ryood/AnVCO/PXL_20220321_074454438.jpg

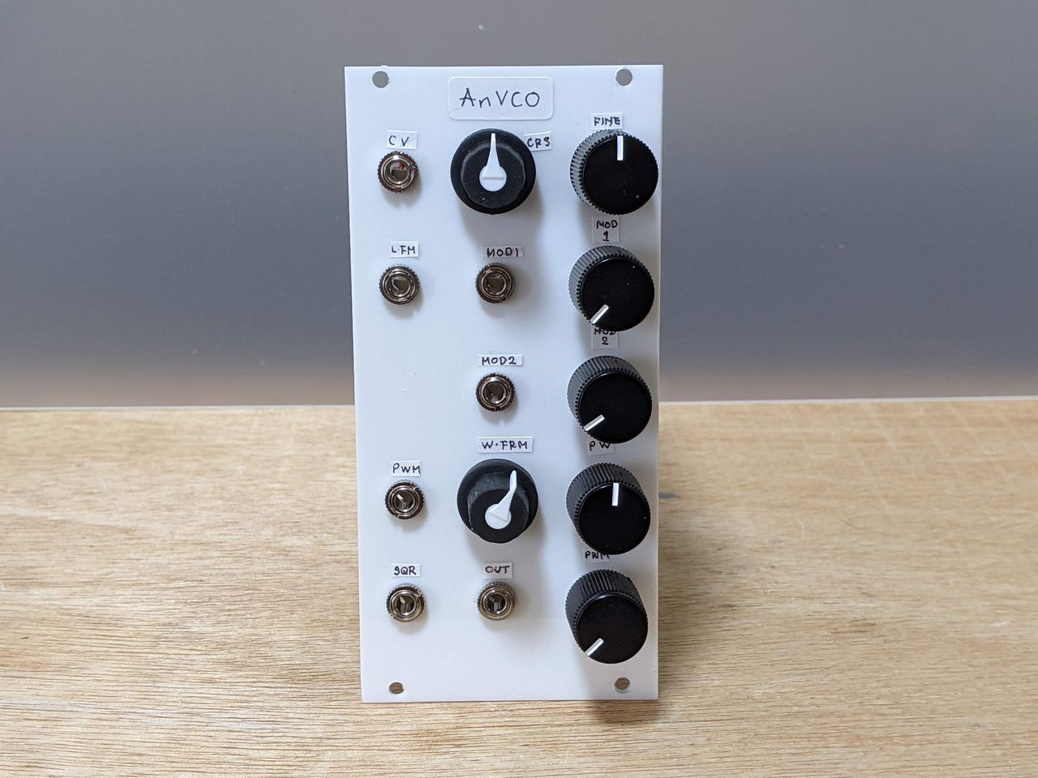
PXL_20220321_074454438.jpg
