ryood/AnVCO/PXL_20220321_074515336.jpg

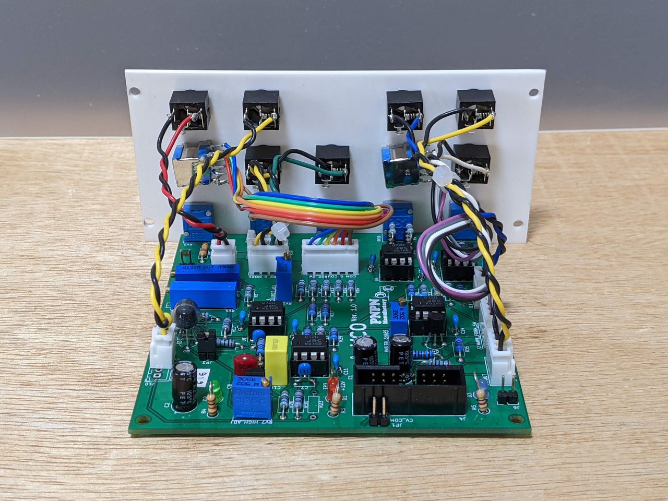
PXL_20220321_074515336.jpg
