ryood/AnVCO/README.md

AnVCO

Analog VCO
  Sawtooth
  Triangle
  Square
