ryood/AnVCO/AnVCO_CVvsOUT_Graph.png

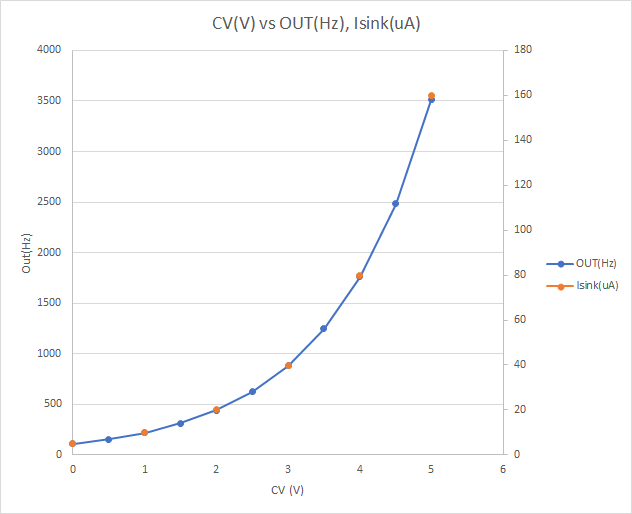
AnVCO_CVvsOUT_Graph.png
