ryood/AnVCO/KiCAD/Anti-Log_sch.PNG

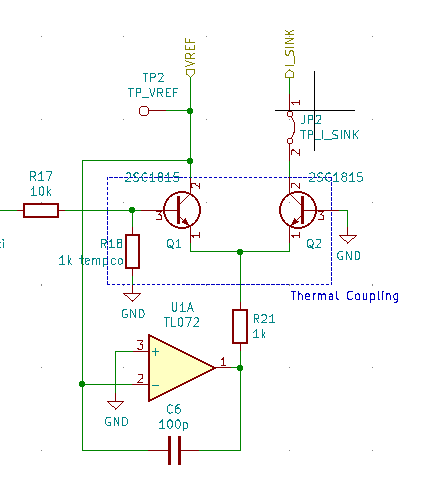
KiCAD/Anti-Log_sch.PNG
