ryood/AnVCO/KiCAD/AnVCO.png

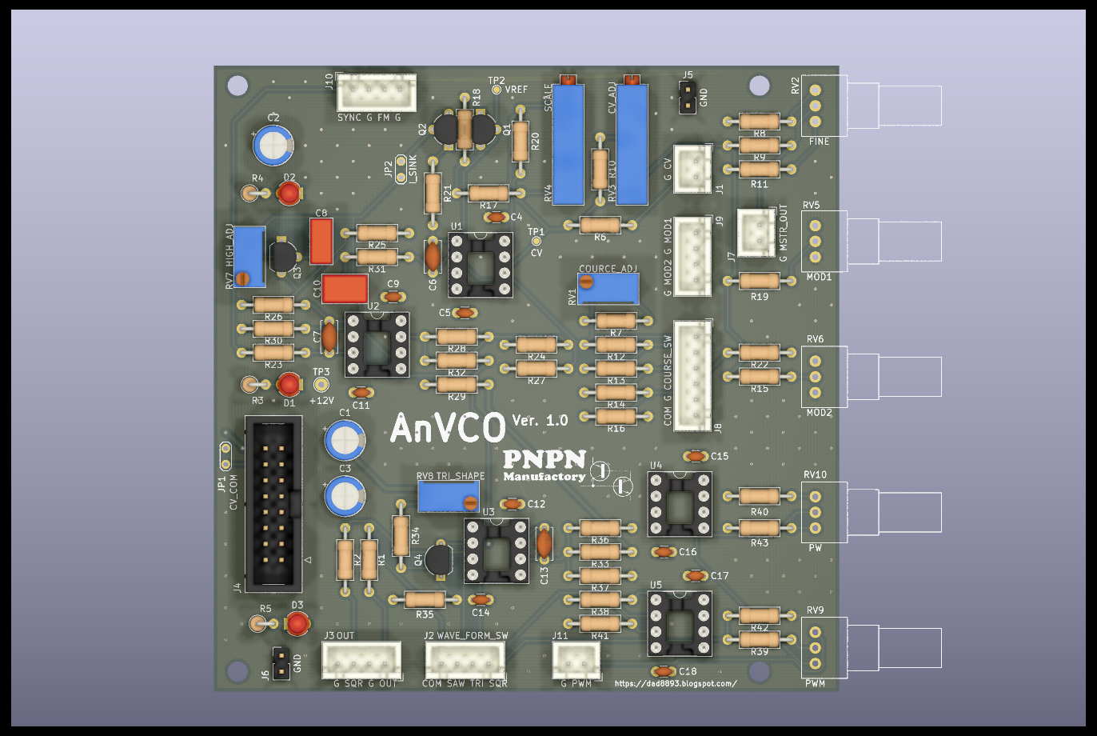
KiCAD/AnVCO.png
