ryood/AnVCO/KiCAD/AnVCO_sch_P1.png

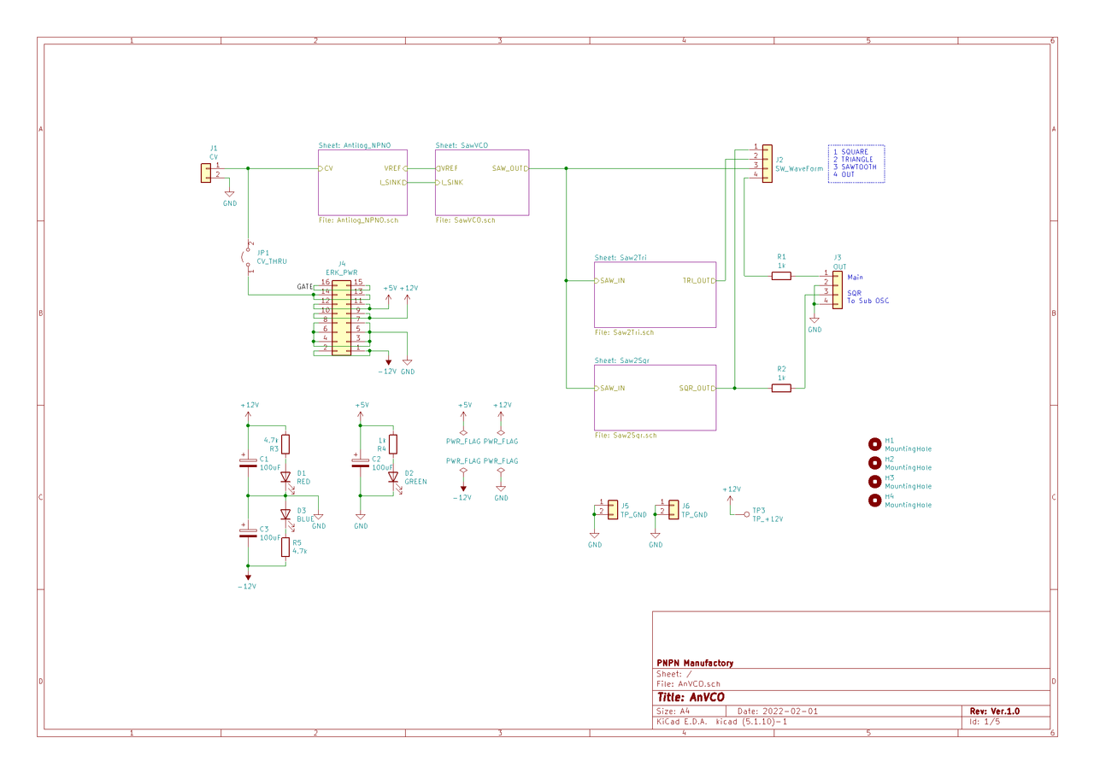
KiCAD/AnVCO_sch_P1.png
