ryood/AnVCO/KiCAD/AnVCO_sch_P2.png

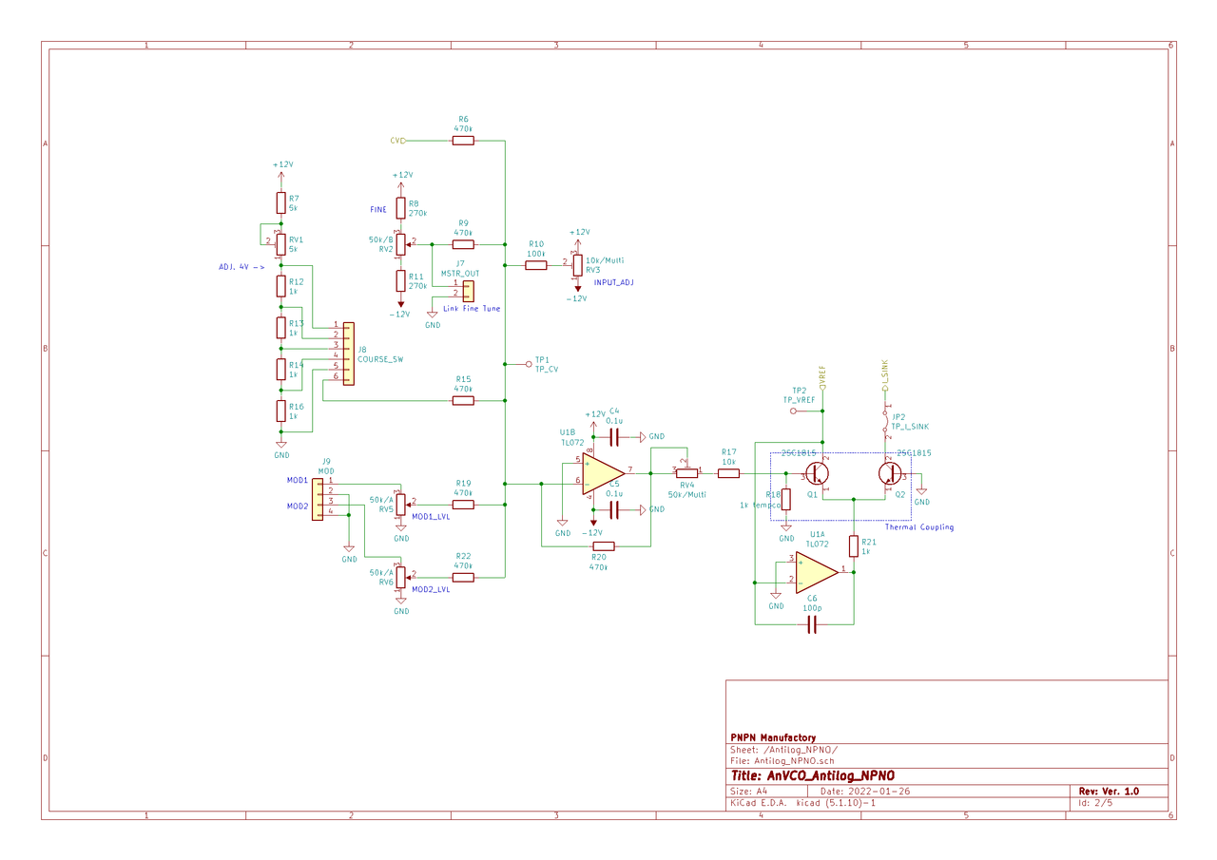
KiCAD/AnVCO_sch_P2.png
