ryood/AnVCO/KiCAD/AnVCO_sch_P3.png

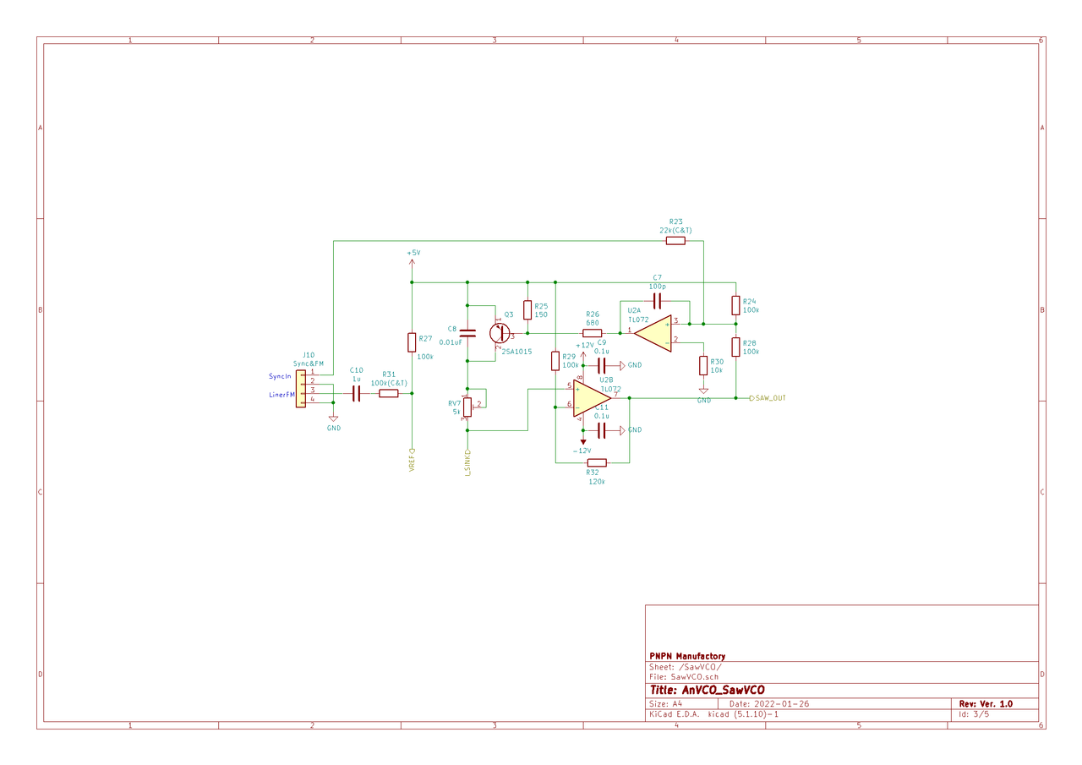
KiCAD/AnVCO_sch_P3.png
