ryood/AnVCO/KiCAD/AnVCO_sch_P4.png

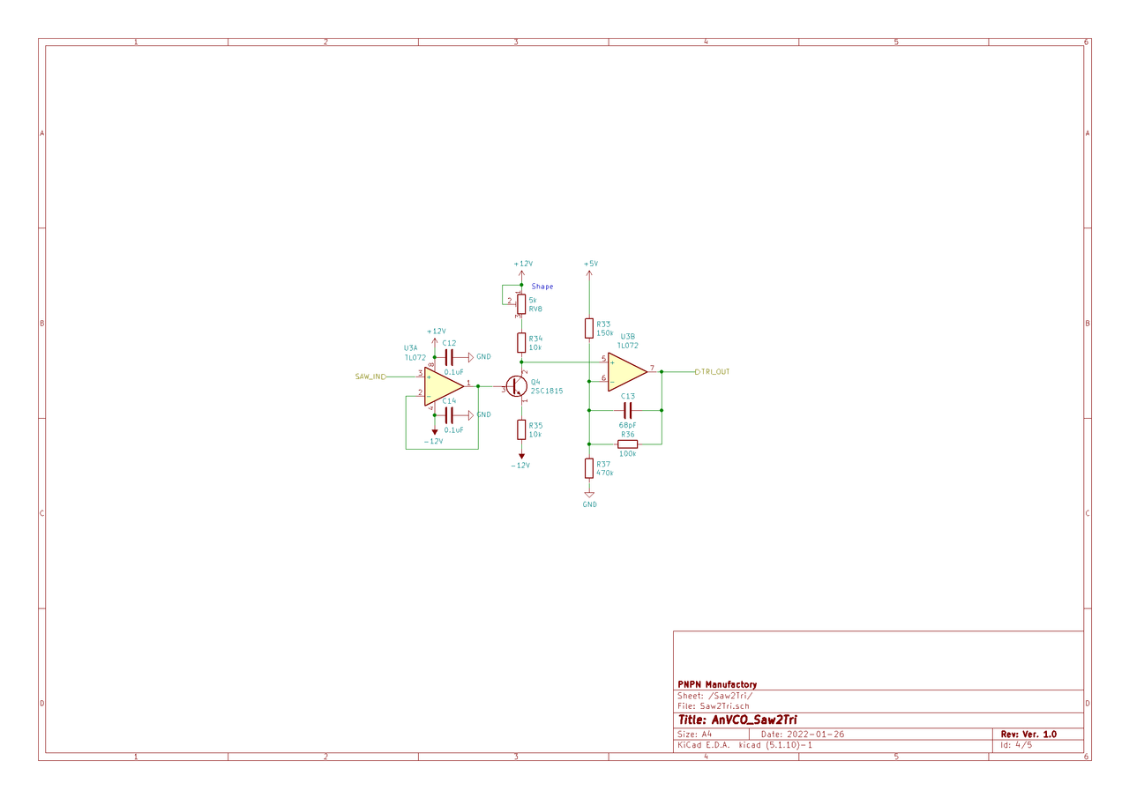
KiCAD/AnVCO_sch_P4.png
