ryood/AnVCO/KiCAD/AnVCO_sch_P5.png

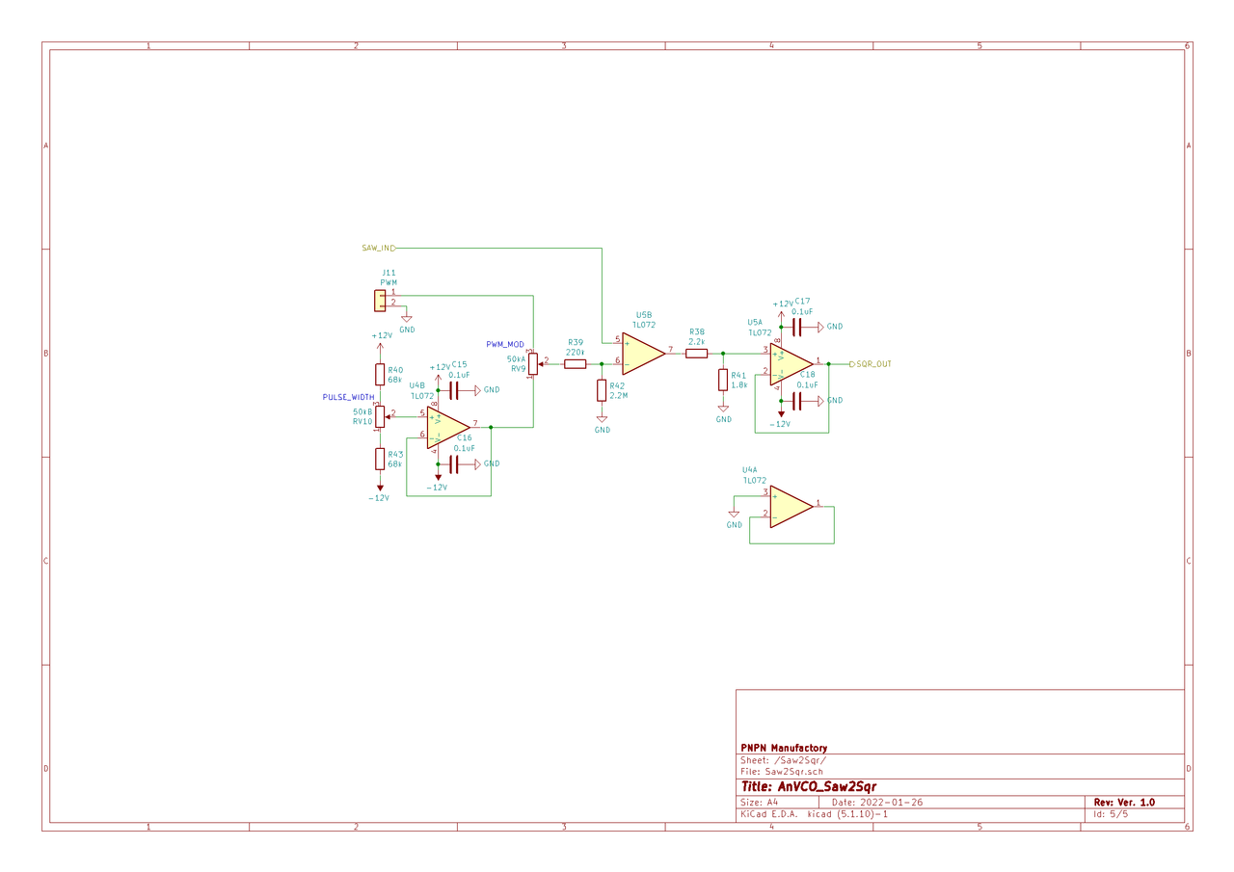
KiCAD/AnVCO_sch_P5.png
