ryood/AnVCO/KiCAD/IMG_20220314_0001.jpg

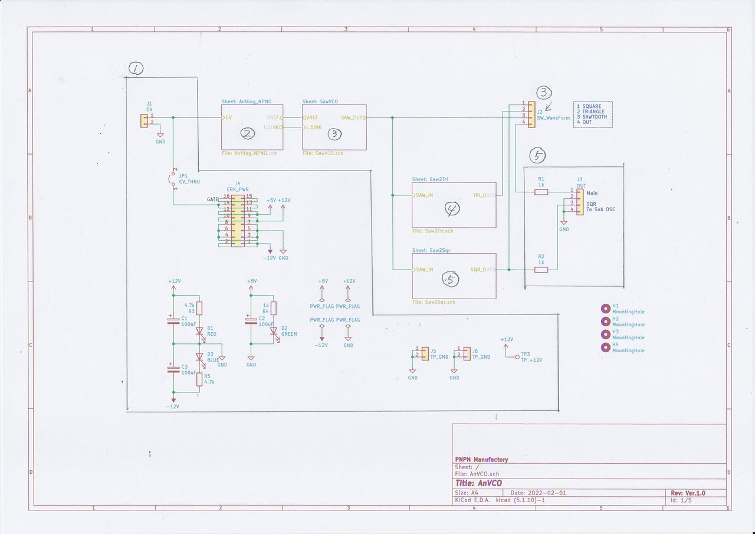
KiCAD/IMG_20220314_0001.jpg
