ryood/AnVCO/KiCAD/IMG_20220318_0003.jpg

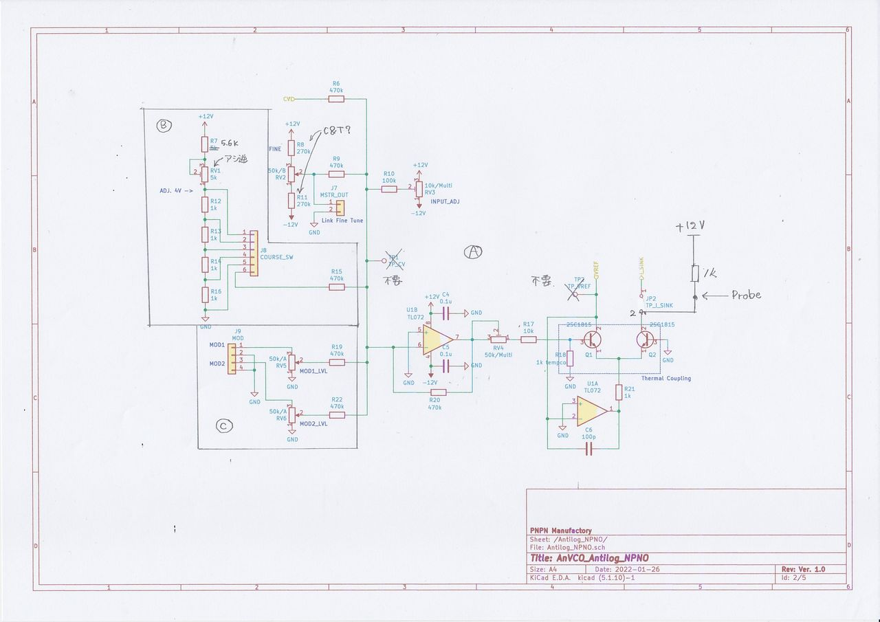
KiCAD/IMG_20220318_0003.jpg
