ryood/AnVCO/KiCAD/IMG_20220320_0001.jpg

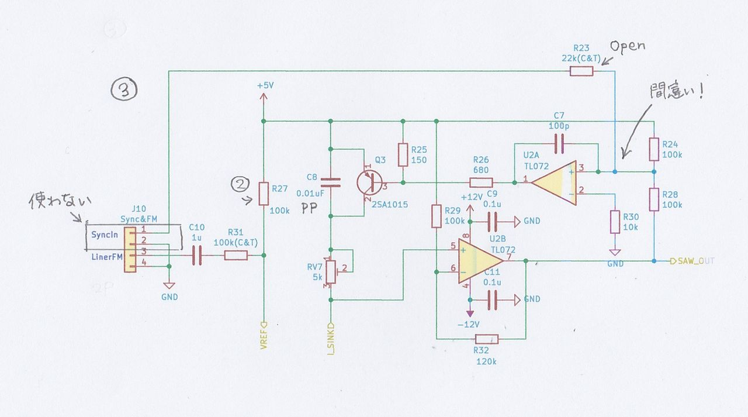
KiCAD/IMG_20220320_0001.jpg
