ryood/AnVCO/KiCAD/IMG_20220321_0001.jpg

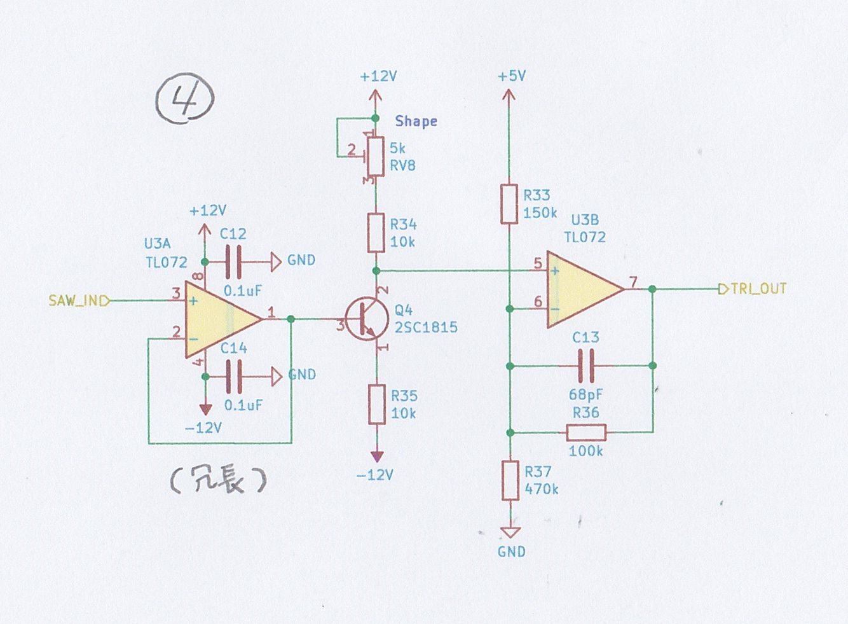
KiCAD/IMG_20220321_0001.jpg
