ryood/AnVCO/KiCAD/IMG_20220321_0003.jpg

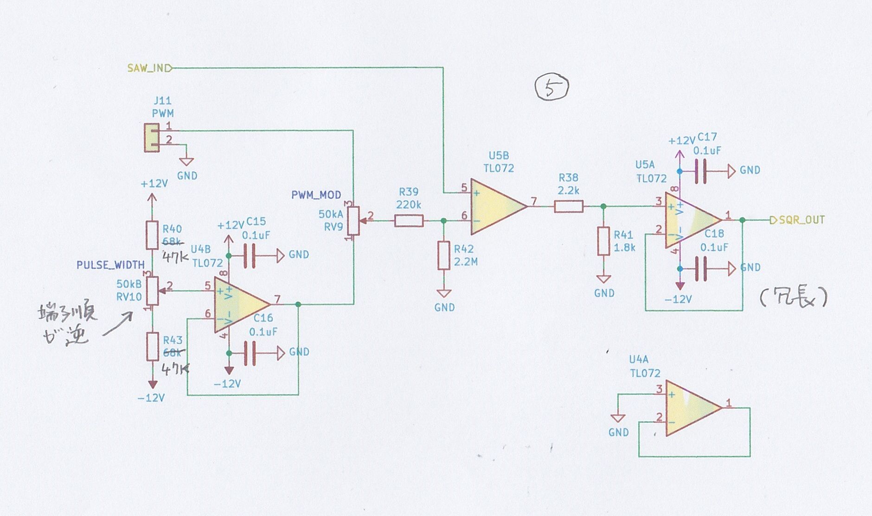
KiCAD/IMG_20220321_0003.jpg
