ryood/AnVCO/PXL_20220221_082823391.jpg

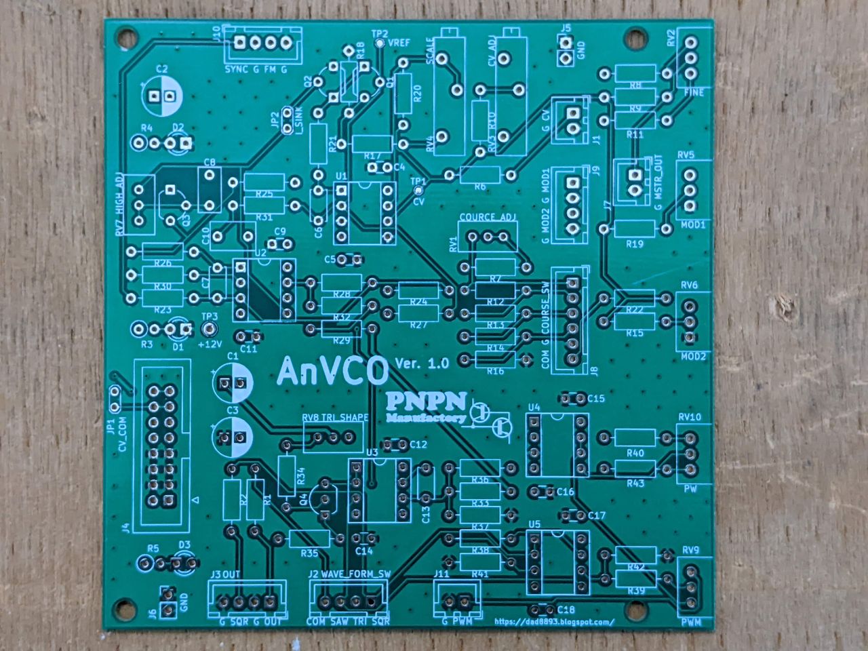
PXL_20220221_082823391.jpg
