ryood/AnVCO/PXL_20220308_063549743.MP.jpg

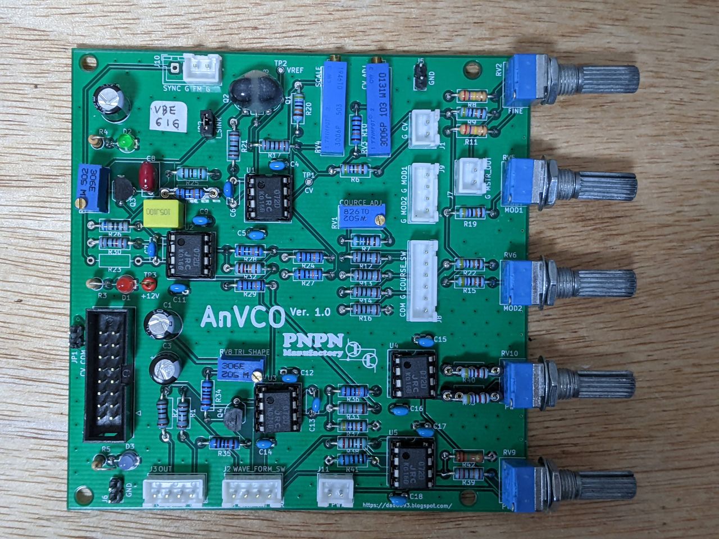
PXL_20220308_063549743.MP.jpg
