ryood/AnVCO/PXL_20220321_074503759.jpg

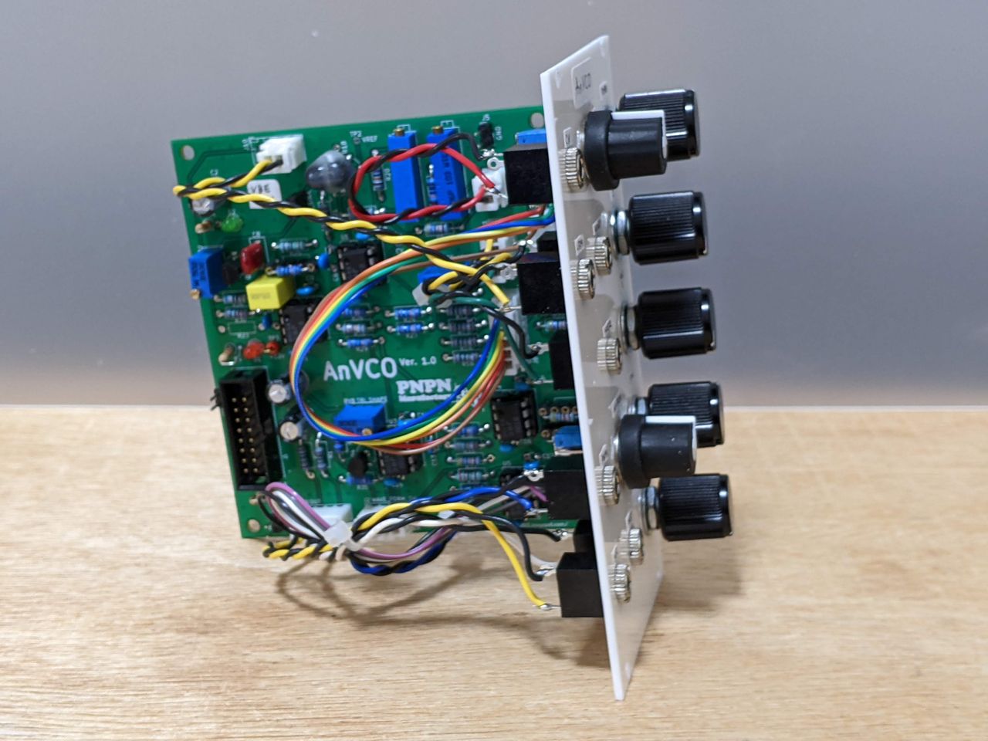
PXL_20220321_074503759.jpg
