ryood/AnVCO/(list of files, cad)

Other CAD files:
CAD/AnVCO_Panel.dwg
CAD/AnVCO_Panel_HP10_R1.dwg
CAD/AnVCO_Panel_HP12.dwg
