ryood/AnVCO/Anti-Log_Test.png

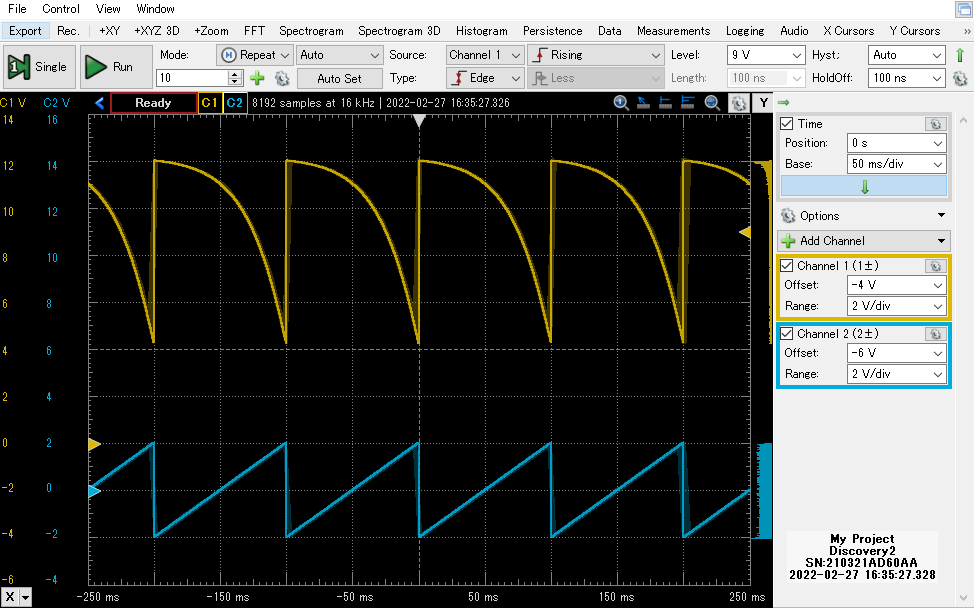
Anti-Log_Test.png
