ryood/AnVCO/spice/Antilog_NPNO_Courase_Test.asc

R1: res; 8k
R2: res; 1k
R3: res; 1k
R4: res; 1k
R5: res; 1k
R6: res; 270k
R7: res; {50k-Rfine}
R8: res; {Rfine}
R9: res; 270k
R10: res; 470k
R11: res; 470k
R12: res; 470k
R13: res; 470k
U1: UniversalOpamp2
V1: voltage; 12
V2: voltage; -12
V3: voltage; SINE(1 1 1k)
Named nets: 0, +12V, C0, C1, C2, C3, C4, -12V, FINE, OUT, CV
.step param Rfine 10k 40k 5k
.tran 3m
