ryood/AnVCO/spice/Antilog_NPNO_Courase_Test_2.asc

R1: res; {12k-Rcoarse}
R5: res; {Rcoarse}
R6: res; 270k
R7: res; {50k-Rfine}
R8: res; {Rfine}
R9: res; 270k
R10: res; 470k
R11: res; 470k
R12: res; 470k
R13: res; 470k
U1: UniversalOpamp2
V1: voltage; 12
V2: voltage; -12
V3: voltage; SINE(1 1 1k)
Named nets: 0, +12V, COARSE, -12V, FINE, OUT, CV
.param Rfine 20k
.tran 3m
.step param Rcoarse list 1 1k 2k   3k 4k
