ryood/AnVCO/spice/Couarce_SW_470k.asc

R1: res; {12k-R}
R2: res; {R}
R3: res; 470k
V1: voltage; 12V
Named nets: 0, OUT
.param R=4k
.tran 1m
