ryood/AnVCO/spice/Couarce_SW_470k_LowImp.asc

R1: res; {1.2k-R}
R2: res; {R}
R3: res; 470k
V1: voltage; 12V
Named nets: 0, OUT
.param R=400
.tran 1m
