ryood/AnVCO/(list of files, drawings)

Other design files:
KiCAD/AnVCO/AnVCO.dsn
