ryood/AnVCO/KiCAD/AnVCO/AnVCO.kicad_pcb

## KiCad design KiCAD/AnVCO/AnVCO.kicad_pcb (2022-03-22)

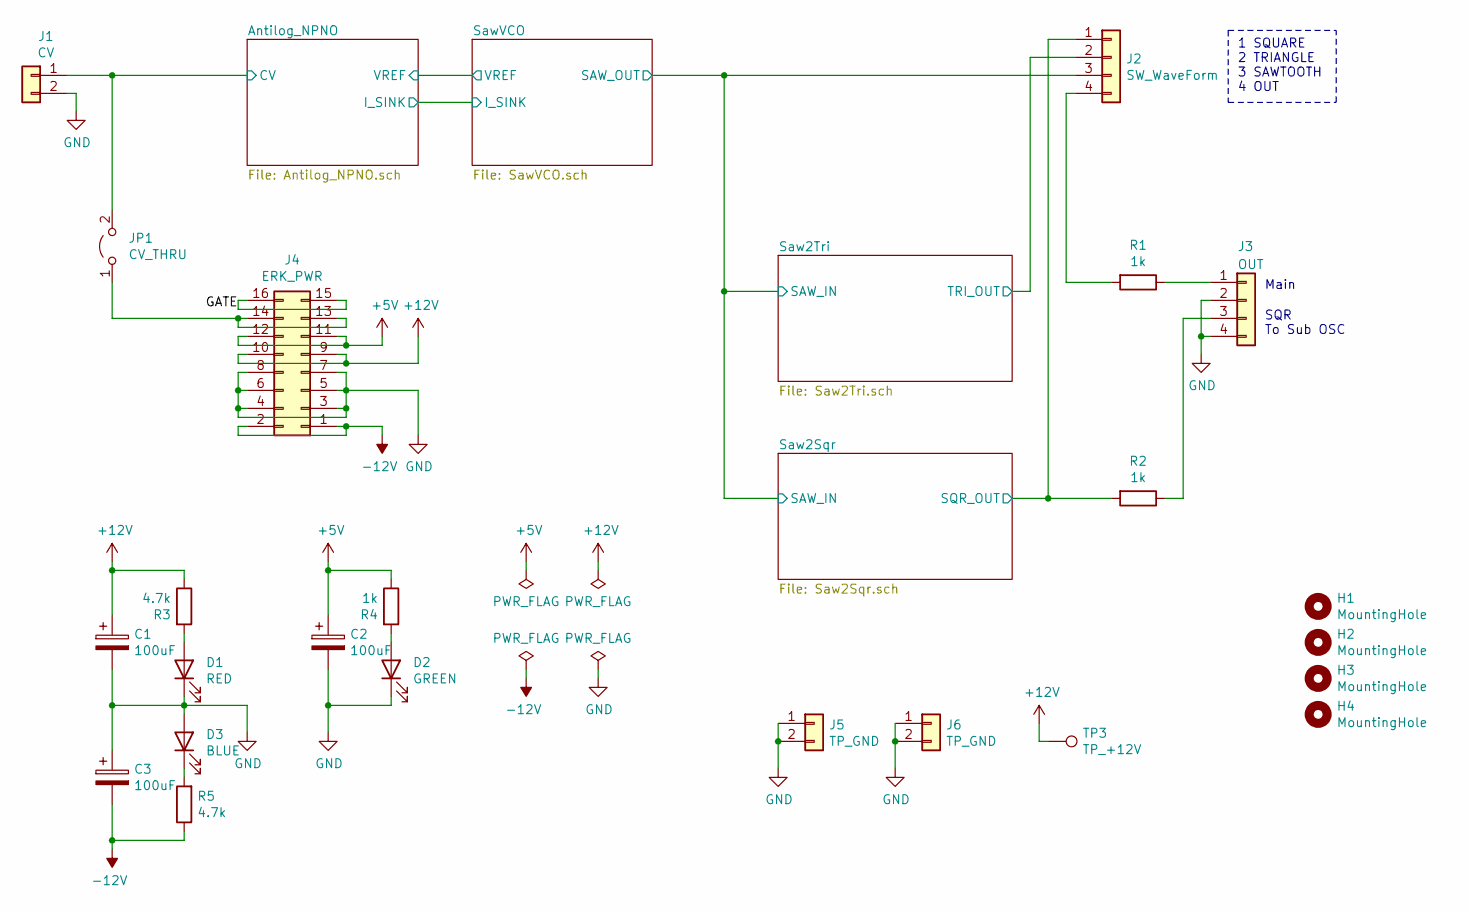
[picture p20: schematic AnVCO.sch]

Parts:
C1, C2, C3: 100uF; CP_Radial_D6.3mm_P2.50mm
D1: RED; LED_D3.0mm
D2: GREEN; LED_D3.0mm
D3: BLUE; LED_D3.0mm
H1, H2, H3, H4: MountingHole; MountingHole_3.2mm_M3
J1: CV; JST_XH_B2B-XH-A_1x02_P2.50mm_Vertical
J2: SW_WaveForm; JST_XH_B4B-XH-A_1x04_P2.50mm_Vertical
J3: OUT; JST_XH_B4B-XH-A_1x04_P2.50mm_Vertical
J4: ERK_PWR; IDC-Header_2x08_P2.54mm_Vertical
J5, J6: TP_GND; PinHeader_1x02_P2.54mm_Vertical
JP1: CV_THRU; TestPoint_2Pads_Pitch2.54mm_Drill0.8mm
R1, R2: 1k; R_Axial_DIN0207_L6.3mm_D2.5mm_P10.16mm_Horizontal
R3, R5: 4.7k; R_Axial_DIN0207_L6.3mm_D2.5mm_P2.54mm_Vertical
R4: 1k; R_Axial_DIN0207_L6.3mm_D2.5mm_P2.54mm_Vertical
TP3: TP_+12V; TestPoint_THTPad_D2.0mm_Drill1.0mm

Connections:
+5V: C2.1, J4.11, J4.12, R4.1; also elsewhere on the board
+12V: C1.1, J4.9, J4.10, R3.1, TP3.1; also elsewhere on the board
-12V: C3.2, J4.1, J4.2, R5.1; also elsewhere on the board
/Antilog_NPNO/CV: J1.1, JP1.2 (B); also elsewhere on the board
/GATE: J4.15, J4.16
/Saw2Sqr/SAW_IN: J2.3; also elsewhere on the board
/Saw2Sqr/SQR_OUT: J2.1, R2.2; also elsewhere on the board
/Saw2Tri/TRI_OUT: J2.2; also elsewhere on the board
GND: C1.2, C2.2, C3.1, D1.1 (K), D2.1 (K), D3.2 (A), J1.2, J3.2, J3.4, J4.3, J4.4, J4.5, J4.6, J4.7, J4.8, J5.1, J5.2, J6.1, J6.2; also elsewhere on the board
unnamed: D1.2 (A), R3.2
unnamed: D2.2 (A), R4.2
unnamed: D3.1 (K), R5.2
unnamed: J2.4, R1.2
unnamed: J3.1, R1.1
unnamed: J3.3, R2.1
unnamed: J4.13, J4.14, JP1.1 (A)

Notes on the sheet:
SQR To Sub OSC
1 SQUARE 2 TRIANGLE 3 SAWTOOTH 4 OUT
Main

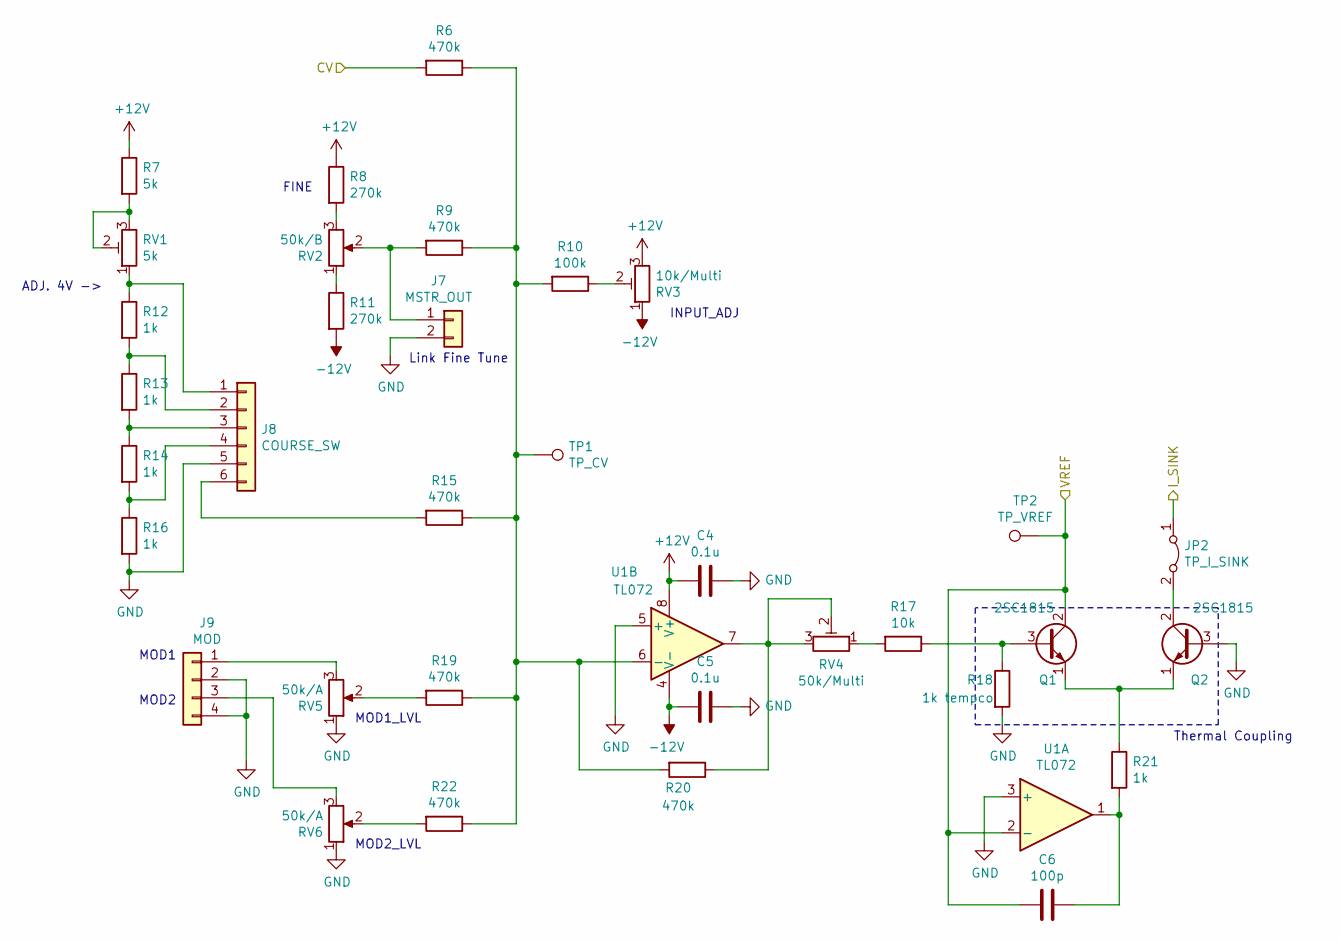
[picture p21: schematic Antilog_NPNO.sch, AnVCO_Antilog_NPNO]

Parts:
C4, C5: 0.1u; C_Disc_D3.0mm_W1.6mm_P2.50mm
C6: 100p; C_Disc_D5.0mm_W2.5mm_P5.00mm
J7: MSTR_OUT; JST_XH_B2B-XH-A_1x02_P2.50mm_Vertical
J8: COURSE_SW; JST_XH_B6B-XH-A_1x06_P2.50mm_Vertical
J9: MOD; JST_XH_B4B-XH-A_1x04_P2.50mm_Vertical
JP2: TP_I_SINK; TestPoint_2Pads_Pitch2.54mm_Drill0.8mm
Q1, Q2: 2SC1815; TO-92_Wide
R6, R9, R15, R19, R20, R22: 470k; R_Axial_DIN0207_L6.3mm_D2.5mm_P10.16mm_Horizontal
R7: 5k; R_Axial_DIN0207_L6.3mm_D2.5mm_P10.16mm_Horizontal
R8, R11: 270k; R_Axial_DIN0207_L6.3mm_D2.5mm_P10.16mm_Horizontal
R10: 100k; R_Axial_DIN0207_L6.3mm_D2.5mm_P10.16mm_Horizontal
R12, R13, R14, R16, R21: 1k; R_Axial_DIN0207_L6.3mm_D2.5mm_P10.16mm_Horizontal
R17: 10k; R_Axial_DIN0207_L6.3mm_D2.5mm_P10.16mm_Horizontal
R18: 1k tempco; R_Axial_DIN0207_L6.3mm_D2.5mm_P10.16mm_Horizontal
RV1: 5k; Potentiometer_Bourns_3296W_Vertical
RV2: 50k/B; Potentiometer_Alps_RK097_Single_Horizontal
RV3: 10k/Multi; Potentiometer_Bourns_3006P_Horizontal
RV4: 50k/Multi; Potentiometer_Bourns_3006P_Horizontal
RV5, RV6: 50k/A; Potentiometer_Alps_RK097_Single_Horizontal
TP1: TP_CV; TestPoint_Pad_D1.0mm
TP2: TP_VREF; TestPoint_Pad_D1.0mm
U1: TL072; DIP-8_W7.62mm_Socket

Connections:
+12V: C4.2, R7.1, R8.1, RV3.3, U1.8 (V+); also elsewhere on the board
-12V: C5.2, R11.2, RV3.1, U1.4 (V-); also elsewhere on the board
/Antilog_NPNO/CV: R6.2; also elsewhere on the board
/Antilog_NPNO/I_SINK: JP2.1 (A); also elsewhere on the board
/Antilog_NPNO/VREF: C6.2, Q1.2 (C), TP2.1, U1.2 (-); also elsewhere on the board
GND: C4.1, C5.1, J7.2, J8.5, J9.2, J9.4, Q2.3 (B), R16.2, R18.2, RV5.1, RV6.1, U1.3 (+), U1.5 (+); also elsewhere on the board
unnamed: C6.1, R21.2, U1.1
unnamed: J7.1, R9.2, RV2.2
unnamed: J8.1, R12.1, RV1.1
unnamed: J8.2, R12.2, R13.1
unnamed: J8.3, R13.2, R14.1
unnamed: J8.4, R14.2, R16.1
unnamed: J8.6, R15.2
unnamed: J9.1, RV5.3
unnamed: J9.3, RV6.3
unnamed: JP2.2 (B), Q2.2 (C)
unnamed: Q1.1 (E), Q2.1 (E), R21.1
unnamed: Q1.3 (B), R17.1, R18.1
unnamed: R7.2, RV1.2, RV1.3
unnamed: R8.2, RV2.3
unnamed: R10.1, RV3.2
unnamed: R6.1, R9.1, R10.2, R15.1, R19.1, R20.2, R22.1, TP1.1, U1.6 (-)
unnamed: R11.1, RV2.1
unnamed: R17.2, RV4.1
unnamed: R19.2, RV5.2
unnamed: R20.1, RV4.2, RV4.3, U1.7
unnamed: R22.2, RV6.2

Notes on the sheet:
FINE
MOD1_LVL
INPUT_ADJ
Thermal Coupling
ADJ. 4V ->
Link Fine Tune
MOD2_LVL
MOD1
MOD2

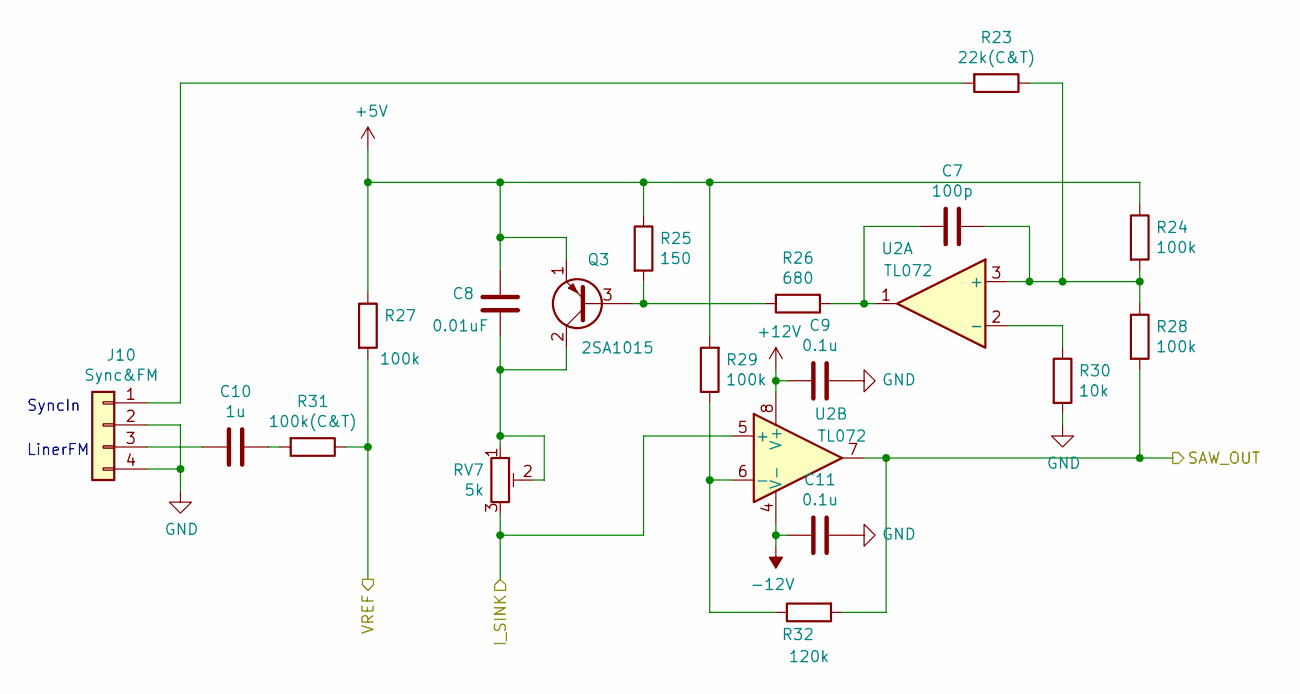
[picture p22: schematic SawVCO.sch, AnVCO_SawVCO]

Parts:
C7: 100p; C_Disc_D5.0mm_W2.5mm_P5.00mm
C8: 0.01uF; C_Rect_L7.2mm_W3.5mm_P5.00mm_FKS2_FKP2_MKS2_MKP2
C9, C11: 0.1u; C_Disc_D3.0mm_W1.6mm_P2.50mm
C10: 1u; C_Rect_L7.2mm_W4.5mm_P5.00mm_FKS2_FKP2_MKS2_MKP2
J10: Sync&FM; JST_XH_B4B-XH-A_1x04_P2.50mm_Vertical
Q3: 2SA1015; TO-92_Wide
R23: 22k(C&T); R_Axial_DIN0207_L6.3mm_D2.5mm_P10.16mm_Horizontal
R24, R27, R28, R29: 100k; R_Axial_DIN0207_L6.3mm_D2.5mm_P10.16mm_Horizontal
R25: 150; R_Axial_DIN0207_L6.3mm_D2.5mm_P10.16mm_Horizontal
R26: 680; R_Axial_DIN0207_L6.3mm_D2.5mm_P10.16mm_Horizontal
R30: 10k; R_Axial_DIN0207_L6.3mm_D2.5mm_P10.16mm_Horizontal
R31: 100k(C&T); R_Axial_DIN0207_L6.3mm_D2.5mm_P10.16mm_Horizontal
R32: 120k; R_Axial_DIN0207_L6.3mm_D2.5mm_P10.16mm_Horizontal
RV7: 5k; Potentiometer_Bourns_3296W_Vertical
U2: TL072; DIP-8_W7.62mm_Socket

Connections:
+5V: C8.2, Q3.1 (E), R24.1, R25.1, R27.1, R29.2; also elsewhere on the board
+12V: C9.2, U2.8 (V+); also elsewhere on the board
-12V: C11.2, U2.4 (V-); also elsewhere on the board
/Antilog_NPNO/I_SINK: RV7.3, U2.5 (+); also elsewhere on the board
/Antilog_NPNO/VREF: R27.2, R31.1; also elsewhere on the board
/Saw2Sqr/SAW_IN: R28.2, R32.2, U2.7; also elsewhere on the board
GND: C9.1, C11.1, J10.2, J10.4, R30.2; also elsewhere on the board
unnamed: C7.1, R23.1, R24.2, R28.1, U2.3 (+)
unnamed: C7.2, R26.1, U2.1
unnamed: C8.1, Q3.2 (C), RV7.1, RV7.2
unnamed: C10.1, R31.2
unnamed: C10.2, J10.3
unnamed: J10.1, R23.2
unnamed: Q3.3 (B), R25.2, R26.2
unnamed: R29.1, R32.1, U2.6 (-)
unnamed: R30.1, U2.2 (-)

Notes on the sheet:
LinerFM
SyncIn

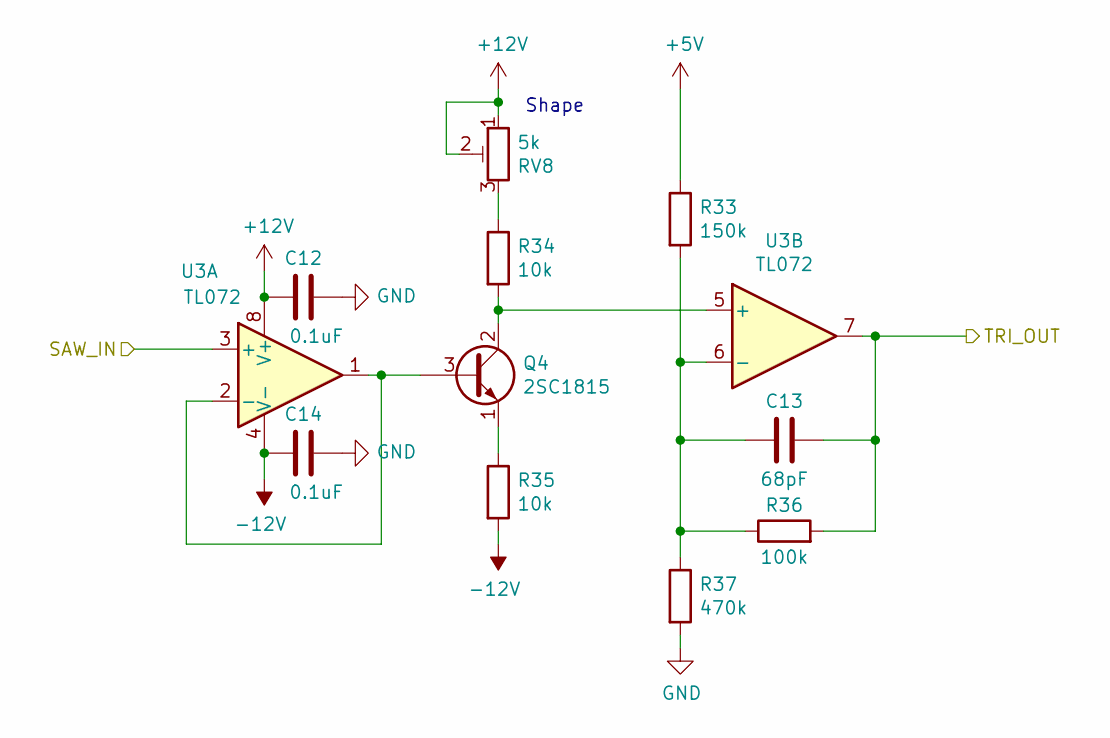
[picture p23: schematic Saw2Tri.sch, AnVCO_Saw2Tri]

Parts:
C12, C14: 0.1uF; C_Disc_D3.0mm_W1.6mm_P2.50mm
C13: 68pF; C_Disc_D5.0mm_W2.5mm_P5.00mm
Q4: 2SC1815; TO-92_Inline_Wide
R33: 150k; R_Axial_DIN0207_L6.3mm_D2.5mm_P10.16mm_Horizontal
R34, R35: 10k; R_Axial_DIN0207_L6.3mm_D2.5mm_P10.16mm_Horizontal
R36: 100k; R_Axial_DIN0207_L6.3mm_D2.5mm_P10.16mm_Horizontal
R37: 470k; R_Axial_DIN0207_L6.3mm_D2.5mm_P10.16mm_Horizontal
RV8: 5k; Potentiometer_Bourns_3296W_Vertical
U3: TL072; DIP-8_W7.62mm_Socket

Connections:
+5V: R33.1; also elsewhere on the board
+12V: C12.2, RV8.1, RV8.2, U3.8 (V+); also elsewhere on the board
-12V: C14.2, R35.2, U3.4 (V-); also elsewhere on the board
/Saw2Sqr/SAW_IN: U3.3 (+); also elsewhere on the board
/Saw2Tri/TRI_OUT: C13.1, R36.2, U3.7; also elsewhere on the board
GND: C12.1, C14.1, R37.2; also elsewhere on the board
unnamed: C13.2, R33.2, R36.1, R37.1, U3.6 (-)
unnamed: Q4.1 (E), R35.1
unnamed: Q4.2 (C), R34.2, U3.5 (+)
unnamed: Q4.3 (B), U3.1, U3.2 (-)
unnamed: R34.1, RV8.3

Notes on the sheet:
Shape

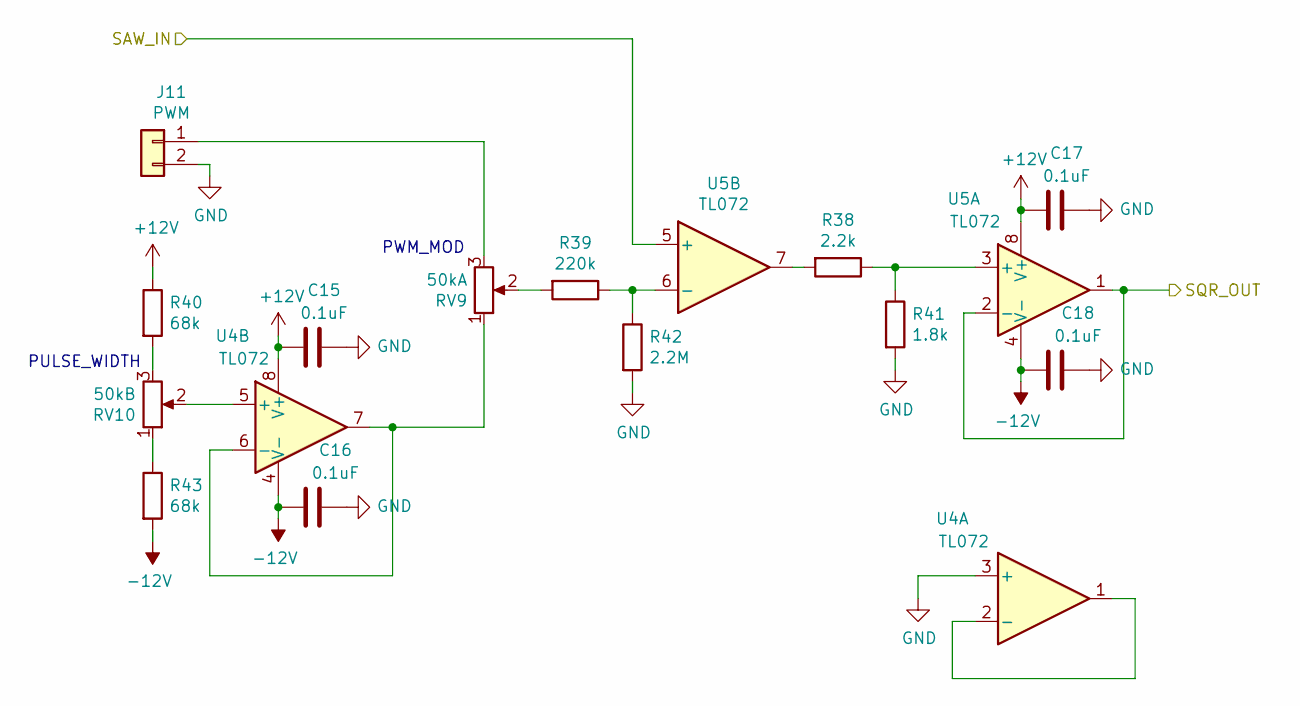
[picture p24: schematic Saw2Sqr.sch, AnVCO_Saw2Sqr]

Parts:
C15, C16, C17, C18: 0.1uF; C_Disc_D3.0mm_W1.6mm_P2.50mm
J11: PWM; JST_XH_B2B-XH-A_1x02_P2.50mm_Vertical
R38: 2.2k; R_Axial_DIN0207_L6.3mm_D2.5mm_P10.16mm_Horizontal
R39: 220k; R_Axial_DIN0207_L6.3mm_D2.5mm_P10.16mm_Horizontal
R40, R43: 68k; R_Axial_DIN0207_L6.3mm_D2.5mm_P10.16mm_Horizontal
R41: 1.8k; R_Axial_DIN0207_L6.3mm_D2.5mm_P10.16mm_Horizontal
R42: 2.2M; R_Axial_DIN0207_L6.3mm_D2.5mm_P10.16mm_Horizontal
RV9: 50kA; Potentiometer_Alps_RK097_Single_Horizontal
RV10: 50kB; Potentiometer_Alps_RK097_Single_Horizontal
U4, U5: TL072; DIP-8_W7.62mm_Socket

Connections:
+12V: C15.2, C17.2, R40.1, U4.8 (V+), U5.8 (V+); also elsewhere on the board
-12V: C16.1, C18.1, R43.2, U4.4 (V-), U5.4 (V-); also elsewhere on the board
/Saw2Sqr/SAW_IN: U5.5 (+); also elsewhere on the board
/Saw2Sqr/SQR_OUT: U5.1, U5.2 (-); also elsewhere on the board
GND: C15.1, C16.2, C17.1, C18.2, J11.2, R41.2, R42.2, U4.3 (+); also elsewhere on the board
unnamed: J11.1, RV9.3
unnamed: R38.1, R41.1, U5.3 (+)
unnamed: R38.2, U5.7
unnamed: R39.1, R42.1, U5.6 (-)
unnamed: R39.2, RV9.2
unnamed: R40.2, RV10.3
unnamed: R43.1, RV10.1
unnamed: RV9.1, U4.6 (-), U4.7
unnamed: RV10.2, U4.5 (+)
unnamed: U4.1, U4.2 (-)

Notes on the sheet:
PULSE_WIDTH
PWM_MOD

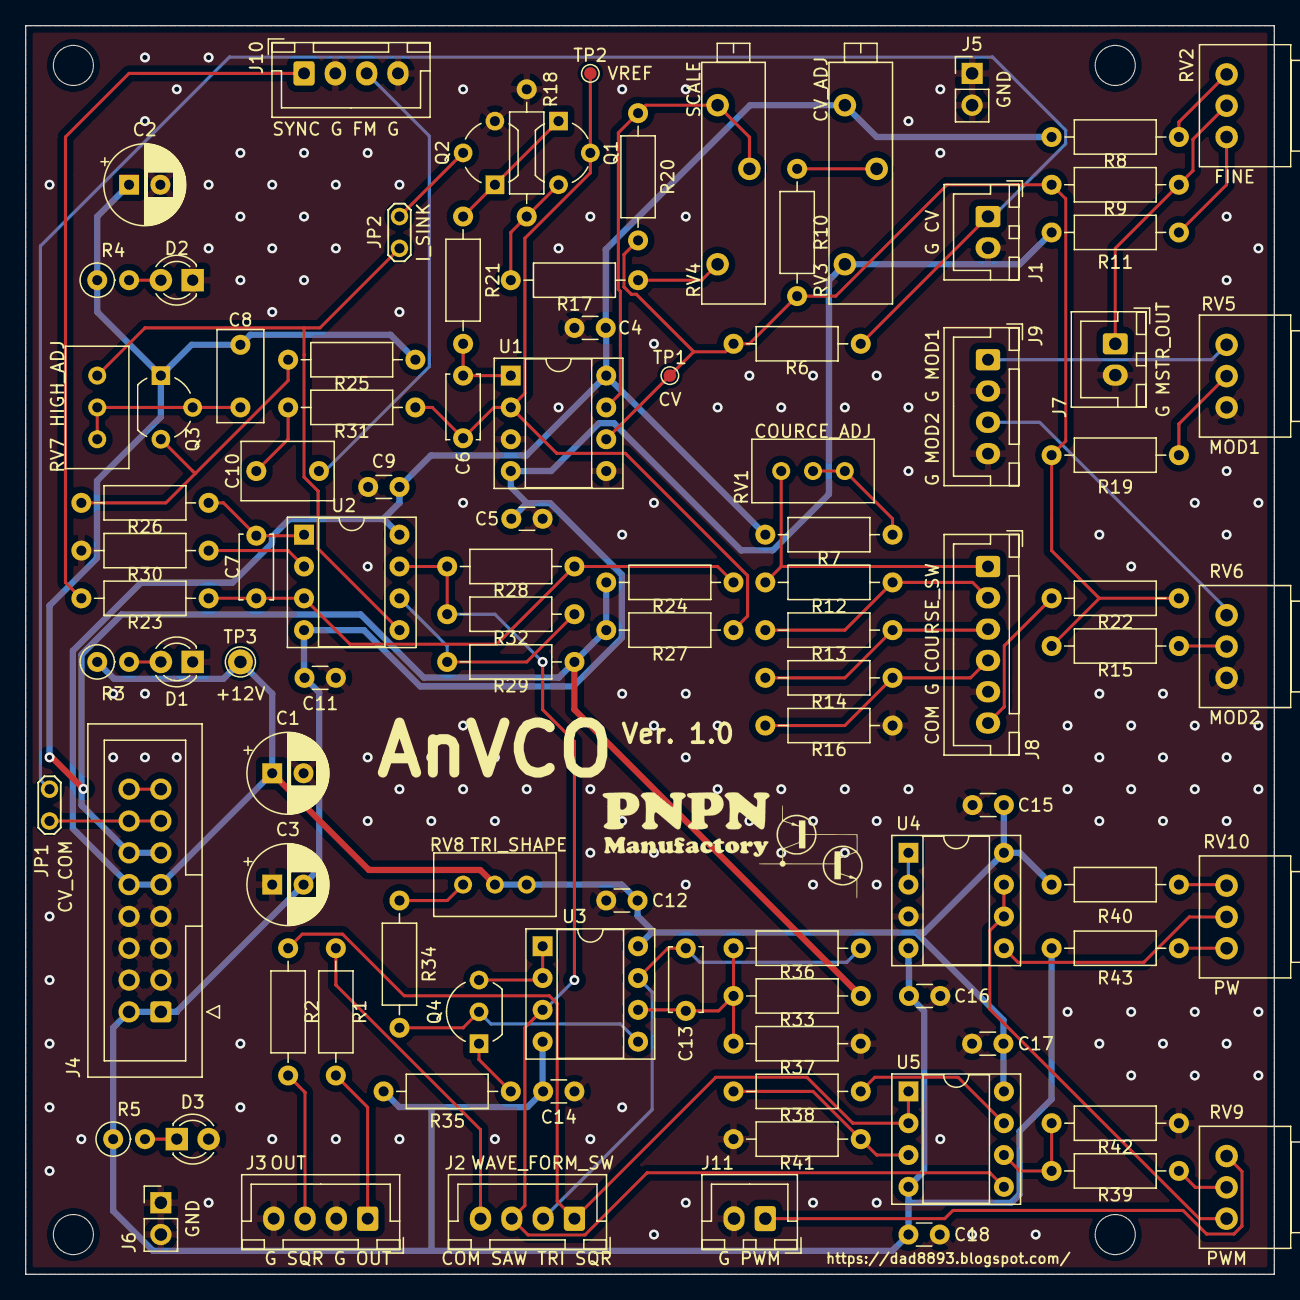
[picture p25: board AnVCO.kicad_pcb from above]

Board: 2 copper layers, 99.7 x 99.7 mm, 103 parts (0 on the bottom side), 63 nets.
