ryood/AnVCO/(commit log)

2022-01-16 KiCAD files
    [AnVCO.kicad_pcb, AnVCO.sch, Antilog_NPNO.sch, Saw2Sqr.sch, Saw2Tri.sch, SawVCO.sch, SubOSC.sch]
2022-02-02 Before wiring
    [AnVCO.sch, Antilog_NPNO.sch, Saw2Sqr.sch, Saw2Tri.sch, SawVCO.sch]
